wh201906/RFIDetector/README.md

# RFIDetector
An opensource hardware project for detecting reader field type(HF/LF)

## Copyright and License
Copyright (c) 2024 wh201906  

All hardware projects in this repository are licensed under [CERN-OHL-S v2](LICENSE.CERN-OHL-S) or any later version.
