wh201906/RFIDetector/simulation/125k.asc

C1: cap; 47µ; V=6.3 Irms=10.8 Rser=0.00432531 Lser=0 mfg="KEMET" pn="C0603C106K9PAC" type="X5R"
C2: cap; 47µ; V=6.3 Irms=10.8 Rser=0.00432531 Lser=0 mfg="KEMET" pn="C0603C106K9PAC" type="X5R"
C3: cap; 47µ; V=6.3 Irms=10.8 Rser=0.00432531 Lser=0 mfg="KEMET" pn="C0603C106K9PAC" type="X5R"
C4: cap; 47µ; V=6.3 Irms=10.8 Rser=0.00432531 Lser=0 mfg="KEMET" pn="C0603C106K9PAC" type="X5R"
C5: cap; 47µ; V=6.3 Irms=10.8 Rser=0.00432531 Lser=0 mfg="KEMET" pn="C0603C106K9PAC" type="X5R"
C6: cap; 47µ; V=6.3 Irms=10.8 Rser=0.00432531 Lser=0
C7: cap; 47µ; V=6.3 Irms=10.8 Rser=0.00432531 Lser=0 mfg="KEMET" pn="C0603C106K9PAC" type="X5R"
C8: cap; 47µ; V=6.3 Irms=10.8 Rser=0.00432531 Lser=0 mfg="KEMET" pn="C0603C106K9PAC" type="X5R"
C9: cap; 47µ; V=6.3 Irms=10.8 Rser=0.00432531 Lser=0 mfg="KEMET" pn="C0603C106K9PAC" type="X5R"
C10: cap; 10µ; V=6.3 Irms=10.8 Rser=0.00432531 Lser=0 mfg="KEMET" pn="C0603C106K9PAC" type="X5R"
C11: cap; 10µ; V=6.3 Irms=10.8 Rser=0.00432531 Lser=0 mfg="KEMET" pn="C0603C106K9PAC" type="X5R"
C12: cap; 100µ; V=6.3 Irms=10.8 Rser=0.00432531 Lser=0
C13: cap; 100µ; V=6.3 Irms=10.8 Rser=0.00432531 Lser=0 mfg="KEMET" pn="C0603C106K9PAC" type="X5R"
C14: cap; 100µ; V=6.3 Irms=10.8 Rser=0.00432531 Lser=0 mfg="KEMET" pn="C0603C106K9PAC" type="X5R"
C15: cap; 100µ; V=6.3 Irms=10.8 Rser=0.00432531 Lser=0 mfg="KEMET" pn="C0603C106K9PAC" type="X5R"
C16: cap; 100µ; V=6.3 Irms=10.8 Rser=0.00432531 Lser=0
C17: cap; 100µ; V=6.3 Irms=10.8 Rser=0.00432531 Lser=0 mfg="KEMET" pn="C0603C106K9PAC" type="X5R"
C18: cap; 100µ; V=6.3 Irms=10.8 Rser=0.00432531 Lser=0 mfg="KEMET" pn="C0603C106K9PAC" type="X5R"
C19: cap; 100µ; V=6.3 Irms=10.8 Rser=0.00432531 Lser=0 mfg="KEMET" pn="C0603C106K9PAC" type="X5R"
D1: schottky; 1N5819
D2: schottky; 1N5819
D3: LED; L128-RED1003500000
D4: schottky; 1N5819
D5: schottky; 1N5819
D6: schottky; 1N5819
D7: LED; L128-RED1003500000
D8: schottky; 1N5819
D9: schottky; 1N5819
D10: schottky; 1N5819
D11: schottky; 1N5819
D12: LED; L128-RED1003500000
D13: schottky; 1N5819
D14: schottky; 1N5819
D15: LED; L128-RED1003500000
D16: schottky; 1N5819
D17: schottky; 1N5819
D18: schottky; 1N5819
D19: schottky; 1N5819
D20: LED; L128-RED1003500000
D22: schottky; BAS40HY
D23: schottky; BAS40HY
D24: schottky; BAS40HY
D25: schottky; BAS40HY
D26: LED; L128-RED1003500000
V1: voltage; SINE(0 3 125k)
V2: voltage; SINE(0 3 125k)
V3: voltage; SINE(0 3 125k)
V4: voltage; SINE(0 3 125k)
V5: voltage; SINE(0 3 125k)
V6: voltage; SINE(0 3 125k)
Named nets: 0, Vdd-3x-half, Vdd-2x-half, Vdd-4x-half, Vdd-2x-half-2, Vdd-4x-half-2, Vdd-4x-half-3
.tran 2ms
https://zhuanlan.zhihu.com/p/585551041
