wh201906/RFIDetector/simulation/13.56M.asc

C1: cap; 47µ; V=6.3 Irms=10.8 Rser=0.00432531 Lser=0
C2: cap; 47µ; V=6.3 Irms=10.8 Rser=0.00432531 Lser=0 mfg="KEMET" pn="C0603C106K9PAC" type="X5R"
C3: cap; 47µ; V=6.3 Irms=10.8 Rser=0.00432531 Lser=0 mfg="KEMET" pn="C0603C106K9PAC" type="X5R"
C4: cap; 47µ; V=6.3 Irms=10.8 Rser=0.00432531 Lser=0 mfg="KEMET" pn="C0603C106K9PAC" type="X5R"
C5: cap; 47µ; V=6.3 Irms=10.8 Rser=0.00432531 Lser=0
C6: cap; 47µ; V=6.3 Irms=10.8 Rser=0.00432531 Lser=0 mfg="KEMET" pn="C0603C106K9PAC" type="X5R"
C7: cap; 47µ; V=6.3 Irms=10.8 Rser=0.00432531 Lser=0 mfg="KEMET" pn="C0603C106K9PAC" type="X5R"
C8: cap; 47µ; V=6.3 Irms=10.8 Rser=0.00432531 Lser=0 mfg="KEMET" pn="C0603C106K9PAC" type="X5R"
C9: cap; 10µ; V=6.3 Irms=10.8 Rser=0.00432531 Lser=0
C10: cap; 10µ; V=6.3 Irms=10.8 Rser=0.00432531 Lser=0 mfg="KEMET" pn="C0603C106K9PAC" type="X5R"
C11: cap; 10µ; V=6.3 Irms=10.8 Rser=0.00432531 Lser=0 mfg="KEMET" pn="C0603C106K9PAC" type="X5R"
C12: cap; 100µ; V=6.3 Irms=10.8 Rser=0.00432531 Lser=0
C13: cap; 100µ; V=6.3 Irms=10.8 Rser=0.00432531 Lser=0 mfg="KEMET" pn="C0603C106K9PAC" type="X5R"
C14: cap; 100µ; V=6.3 Irms=10.8 Rser=0.00432531 Lser=0 mfg="KEMET" pn="C0603C106K9PAC" type="X5R"
C15: cap; 100µ; V=6.3 Irms=10.8 Rser=0.00432531 Lser=0 mfg="KEMET" pn="C0603C106K9PAC" type="X5R"
C16: cap; 10µ; V=6.3 Irms=10.8 Rser=0.00432531 Lser=0 mfg="KEMET" pn="C0603C106K9PAC" type="X5R"
C20: cap; 100µ; V=6.3 Irms=10.8 Rser=0.00432531 Lser=0
C21: cap; 100µ; V=6.3 Irms=10.8 Rser=0.00432531 Lser=0 mfg="KEMET" pn="C0603C106K9PAC" type="X5R"
C22: cap; 100µ; V=6.3 Irms=10.8 Rser=0.00432531 Lser=0 mfg="KEMET" pn="C0603C106K9PAC" type="X5R"
C23: cap; 100µ; V=6.3 Irms=10.8 Rser=0.00432531 Lser=0 mfg="KEMET" pn="C0603C106K9PAC" type="X5R"
D1: schottky; 1N5819
D2: schottky; 1N5819
D3: schottky; 1N5819
D4: schottky; 1N5819
D5: LED; L128-RED1003500000
D6: schottky; 1N5819
D7: schottky; 1N5819
D8: schottky; 1N5819
D9: schottky; 1N5819
D10: LED; L128-RED1003500000
D11: schottky; 1N5819
D12: schottky; 1N5819
D13: schottky; 1N5819
D14: schottky; 1N5819
D15: LED; L128-RED1003500000
D16: schottky; 1N5819
D17: schottky; 1N5819
D18: schottky; 1N5819
D19: schottky; 1N5819
D20: LED; L128-RED1003500000
D21: schottky; 1N5819
D27: schottky; 1N5819
D28: schottky; 1N5819
D29: schottky; 1N5819
D30: LED; L128-RED1003500000
V1: voltage; SINE(0 3 125k)
V2: voltage; SINE(0 3 13560k)
V3: voltage; SINE(0 3 13560k)
V5: voltage; SINE(0 3 125k)
V7: voltage; SINE(0 3 13560k)
Named nets: 0, Vdd-4x-half-125k, Vdd-4x-half-13M, Vdd-4x-half-125k-2, Vdd-4x-half-13M-2, Vdd-4x-half-13M-3
.tran 800us
https://zhuanlan.zhihu.com/p/585551041
