wh201906/RFIDetector/hardware/rev0.12/RFIDetector.kicad_pcb

## KiCad design hardware/rev0.12/RFIDetector.kicad_pcb (2024-03-22, an earlier design)

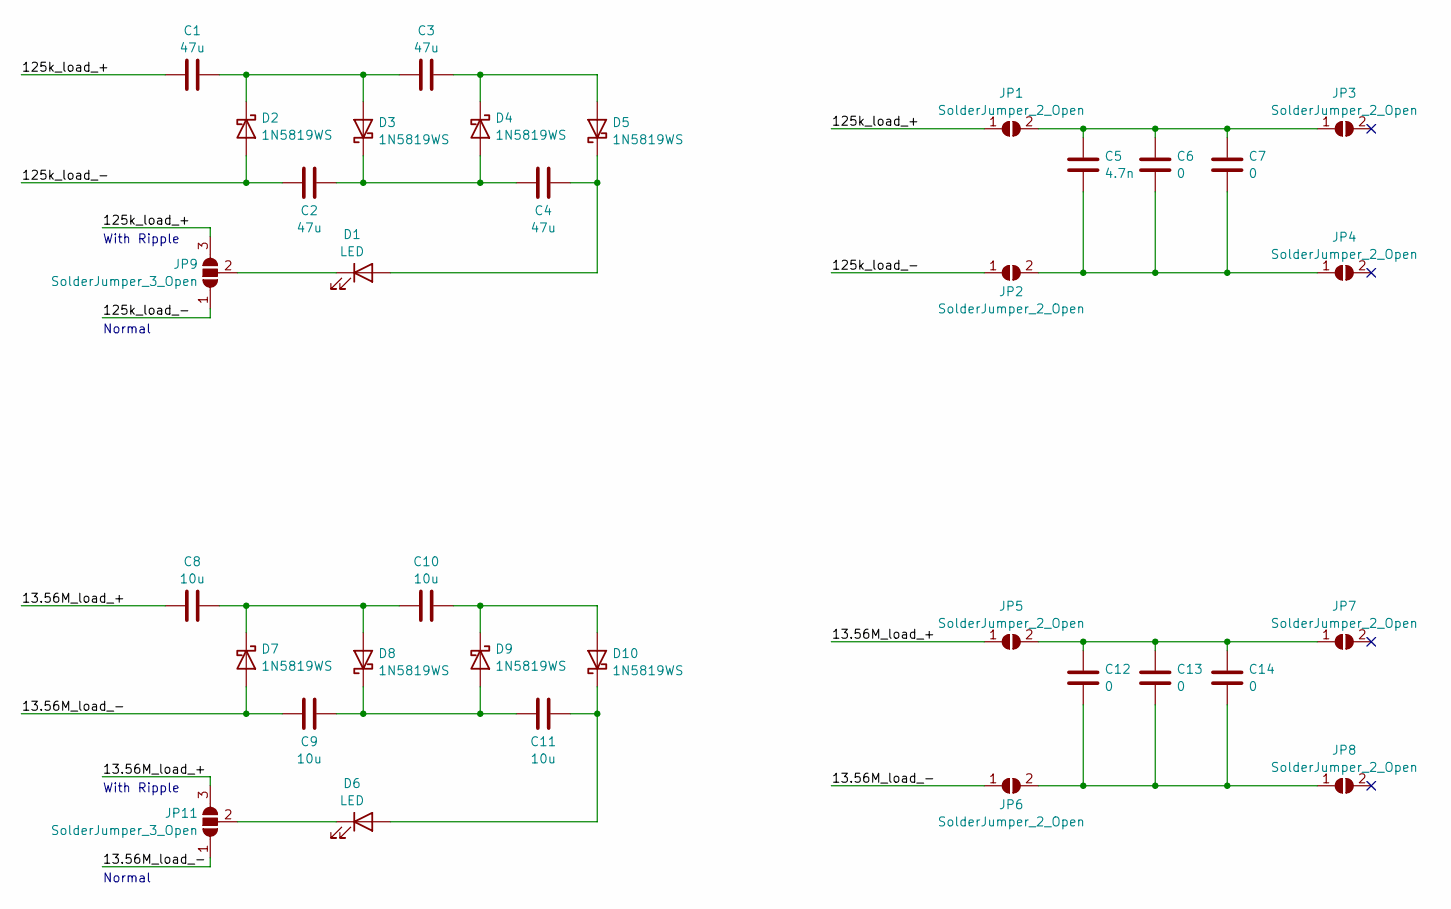
[picture p1: schematic RFIDetector.kicad_sch]

Parts:
C1, C2, C3, C4: 47u; C_0603_1608Metric_Pad1.08x0.95mm_HandSolder
C5: 4.7n; C_0603_1608Metric_Pad1.08x0.95mm_HandSolder
C6, C7, C12, C13, C14: 0; C_0603_1608Metric_Pad1.08x0.95mm_HandSolder
C8, C9, C10, C11: 10u; C_0603_1608Metric_Pad1.08x0.95mm_HandSolder
D1, D6: LED; LED_0603_1608Metric_Pad1.05x0.95mm_HandSolder
D2, D3, D4, D5, D7, D8, D9, D10: 1N5819WS; D_SOD-323_HandSoldering
JP1, JP2, JP3, JP4, JP5, JP6, JP7, JP8: SolderJumper_2_Open; SolderJumper-2_P1.3mm_Open_RoundedPad1.0x1.5mm
JP9, JP11: SolderJumper_3_Open; SolderJumper-3_P1.3mm_Open_RoundedPad1.0x1.5mm

Connections:
/13.56M_load_+: C8.1, JP5.1 (A), JP11.3 (B)
/13.56M_load_-: C9.1, D7.2 (A), JP6.1 (A), JP11.1 (A)
/125k_load_+: C1.1, JP1.1 (A), JP9.3 (B)
/125k_load_-: C2.1, D2.2 (A), JP2.1 (A), JP9.1 (A)
unnamed: C4.2, D1.2 (A), D5.1 (K)
unnamed: D1.1 (K), JP9.2 (C)
unnamed: C1.2, C3.1, D2.1 (K), D3.2 (A)
unnamed: C2.2, C4.1, D3.1 (K), D4.2 (A)
unnamed: C3.2, D4.1 (K), D5.2 (A)
unnamed: D6.1 (K), JP11.2 (C)
unnamed: C8.2, C10.1, D7.1 (K), D8.2 (A)
unnamed: C9.2, C11.1, D8.1 (K), D9.2 (A)
unnamed: C10.2, D9.1 (K), D10.2 (A)
unnamed: C11.2, D6.2 (A), D10.1 (K)
unnamed: C5.2, C6.2, C7.2, JP1.2 (B), JP3.1 (A)
unnamed: C5.1, C6.1, C7.1, JP2.2 (B), JP4.1 (A)
unnamed: C12.1, C13.1, C14.1, JP5.2 (B), JP7.1 (A)
unnamed: C12.2, C13.2, C14.2, JP6.2 (B), JP8.1 (A)

Notes on the sheet:
Normal
With Ripple

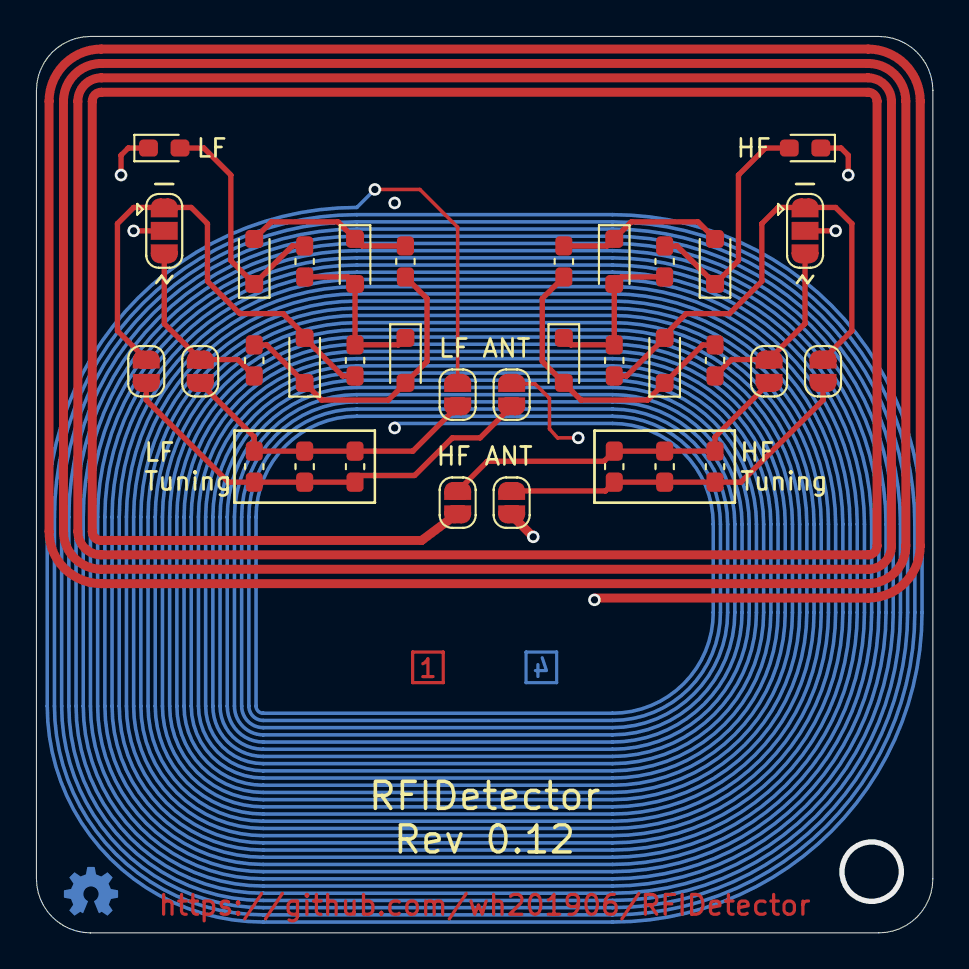
[picture p2: board hardware/rev0.12/RFIDetector.kicad_pcb from above]

Board: 4 copper layers, 49.8 x 49.8 mm, 34 parts (0 on the bottom side), 18 nets.
