wh201906/RFIDetector/tuner/tuner_adapter/tuner_adapter.kicad_pcb

## KiCad design tuner/tuner_adapter/tuner_adapter.kicad_pcb (2024-02-29)

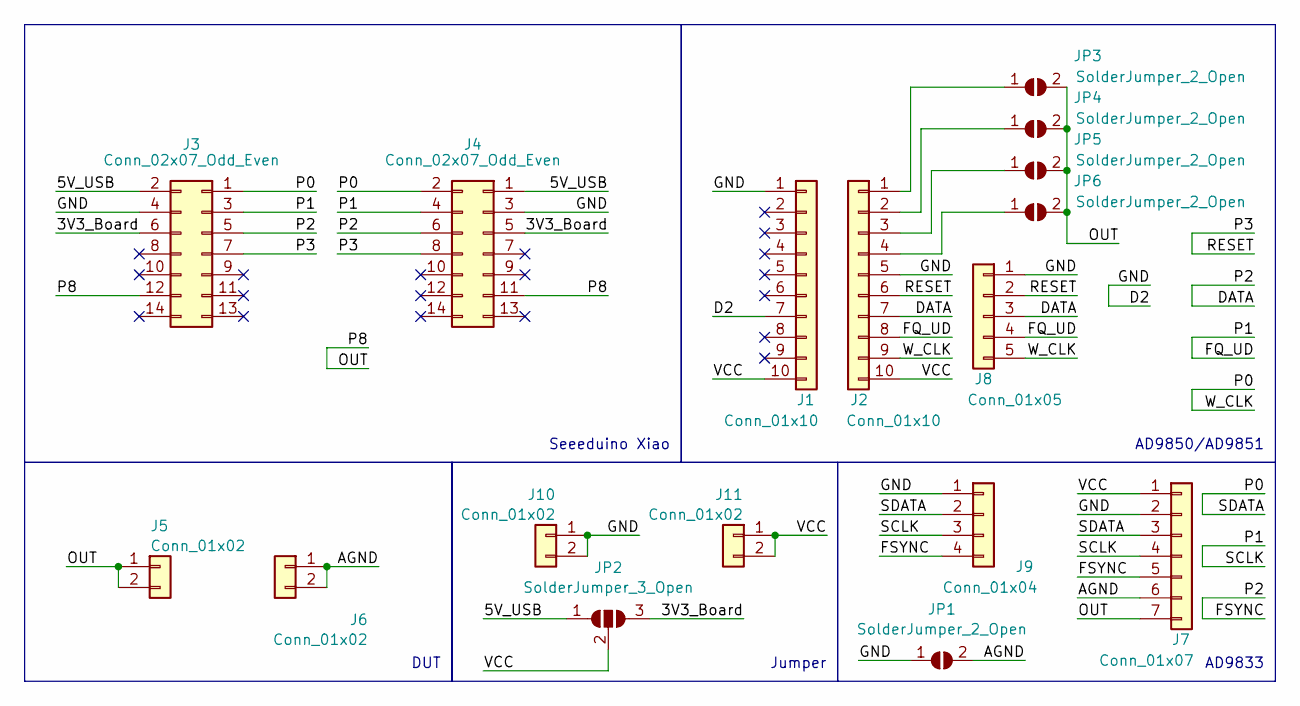
[picture p3: schematic tuner_adapter.kicad_sch]

Parts:
J1, J2: Conn_01x10; PinSocket_1x10_P2.54mm_Vertical
J3, J4: Conn_02x07_Odd_Even; PinSocket_2x07_P2.54mm_Vertical
J5, J6: Conn_01x02; PinSocket_1x02_P2.54mm_Vertical
J7: Conn_01x07; PinSocket_1x07_P2.54mm_Vertical
J8: Conn_01x05; PinHeader_1x05_P2.54mm_Vertical
J9: Conn_01x04; PinHeader_1x04_P2.54mm_Vertical
J10, J11: Conn_01x02; PinHeader_1x02_P2.54mm_Vertical
JP1, JP3, JP4, JP5, JP6: SolderJumper_2_Open; SolderJumper-2_P1.3mm_Open_RoundedPad1.0x1.5mm
JP2: SolderJumper_3_Open; SolderJumper-3_P1.3mm_Open_RoundedPad1.0x1.5mm

Connections:
/3V3_Board: J3.6, J4.5, JP2.3 (B)
/5V_USB: J3.2, J4.1, JP2.1 (A)
/AGND: J6.1, J6.2, J7.6, JP1.2 (B)
/D2: J1.1, J1.7, J2.5, J3.4, J4.3, J7.2, J8.1, J9.1, J10.1, J10.2, JP1.1 (A)
/DATA: J2.7, J3.5, J4.6, J7.5, J8.3, J9.4
/FQ_UD: J2.8, J3.3, J4.4, J7.4, J8.4, J9.3
/OUT: J3.12, J4.11, J5.1, J5.2, J7.7, JP3.2 (B), JP4.2 (B), JP5.2 (B), JP6.2 (B)
/P0: J2.9, J3.1, J4.2, J7.3, J8.5, J9.2
/P3: J2.6, J3.7, J4.8, J8.2
/VCC: J1.10, J2.10, J7.1, J11.1, J11.2, JP2.2 (C)
unnamed: J2.1, JP3.1 (A)
unnamed: J2.2, JP4.1 (A)
unnamed: J2.3, JP5.1 (A)
unnamed: J2.4, JP6.1 (A)

Notes on the sheet:
Jumper
AD9833
AD9850/AD9851
DUT
Seeeduino Xiao

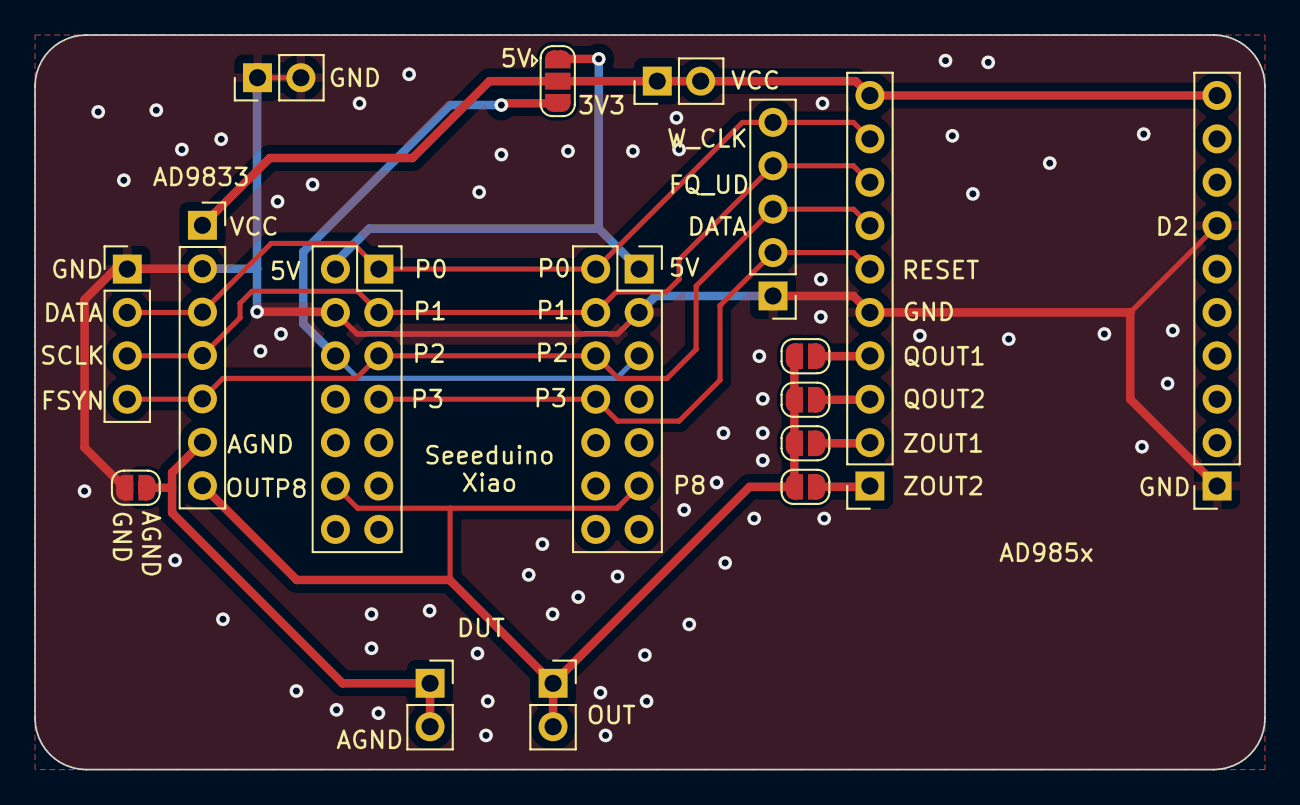
[picture p4: board tuner_adapter.kicad_pcb from above]

Board: 2 copper layers, 72.0 x 43.0 mm, 17 parts (0 on the bottom side), 14 nets.
