wh201906/RFIDetector/hardware/rev0.1/RFIDetector.kicad_pcb

## KiCad design hardware/rev0.1/RFIDetector.kicad_pcb (2024-01-28, an earlier design)

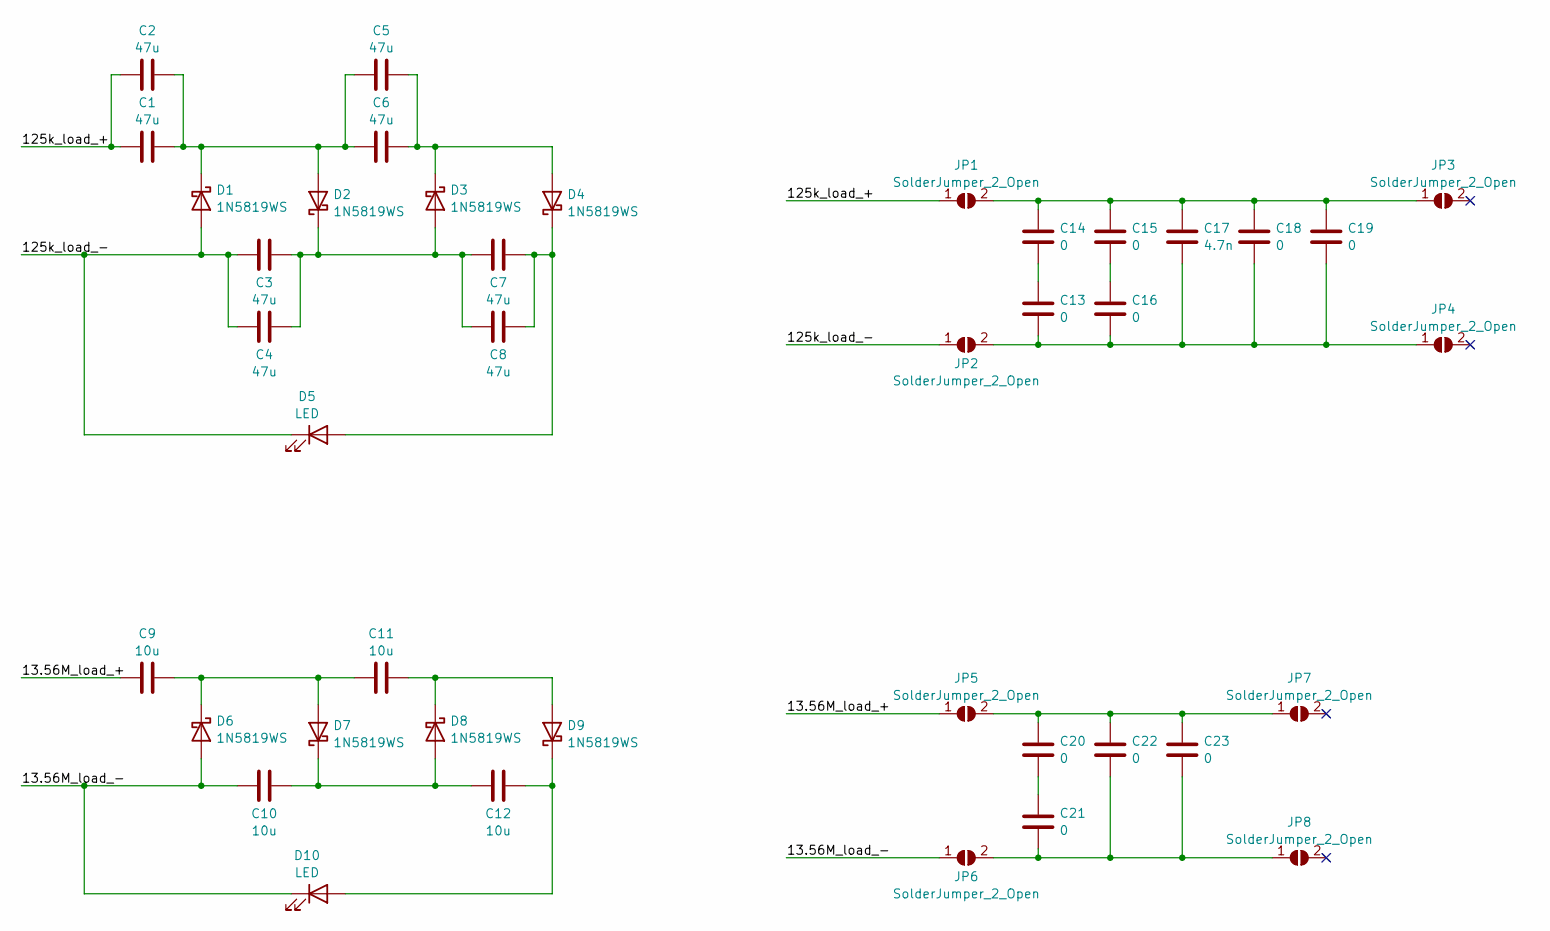
[picture p7: schematic RFIDetector.kicad_sch]

Parts:
C1, C2, C3, C4, C5, C6, C7, C8: 47u; C_0603_1608Metric_Pad1.08x0.95mm_HandSolder
C9, C10, C11, C12: 10u; C_0603_1608Metric_Pad1.08x0.95mm_HandSolder
C13, C14, C15, C16, C18, C19, C20, C21, C22, C23: 0; C_0603_1608Metric_Pad1.08x0.95mm_HandSolder
C17: 4.7n; C_0603_1608Metric_Pad1.08x0.95mm_HandSolder
D1, D2, D3, D4, D6, D7, D8, D9: 1N5819WS; D_SOD-323_HandSoldering
D5, D10: LED; LED_0603_1608Metric_Pad1.05x0.95mm_HandSolder
JP1, JP2, JP3, JP4, JP5, JP6, JP7, JP8: SolderJumper_2_Open; SolderJumper-2_P1.3mm_Open_RoundedPad1.0x1.5mm

Connections:
/13.56M_load_+: C9.1, JP5.1 (A)
/13.56M_load_-: C10.1, D6.2 (A), D10.1 (K), JP6.1 (A)
/125k_load_+: C1.1, C2.1, JP1.1 (A)
/125k_load_-: C3.1, C4.1, D1.2 (A), D5.1 (K), JP2.1 (A)
unnamed: C13.1, C14.1
unnamed: C15.2, C16.1
unnamed: C20.1, C21.1
unnamed: C1.2, C2.2, C5.1, C6.1, D1.1 (K), D2.2 (A)
unnamed: C3.2, C4.2, C7.1, C8.1, D2.1 (K), D3.2 (A)
unnamed: C5.2, C6.2, D3.1 (K), D4.2 (A)
unnamed: C7.2, C8.2, D4.1 (K), D5.2 (A)
unnamed: C9.2, C11.1, D6.1 (K), D7.2 (A)
unnamed: C10.2, C12.1, D7.1 (K), D8.2 (A)
unnamed: C11.2, D8.1 (K), D9.2 (A)
unnamed: C12.2, D9.1 (K), D10.2 (A)
unnamed: C14.2, C15.1, C17.2, C18.2, C19.2, JP1.2 (B), JP3.1 (A)
unnamed: C13.2, C16.2, C17.1, C18.1, C19.1, JP2.2 (B), JP4.1 (A)
unnamed: C20.2, C22.1, C23.1, JP5.2 (B), JP7.1 (A)
unnamed: C21.2, C22.2, C23.2, JP6.2 (B), JP8.1 (A)

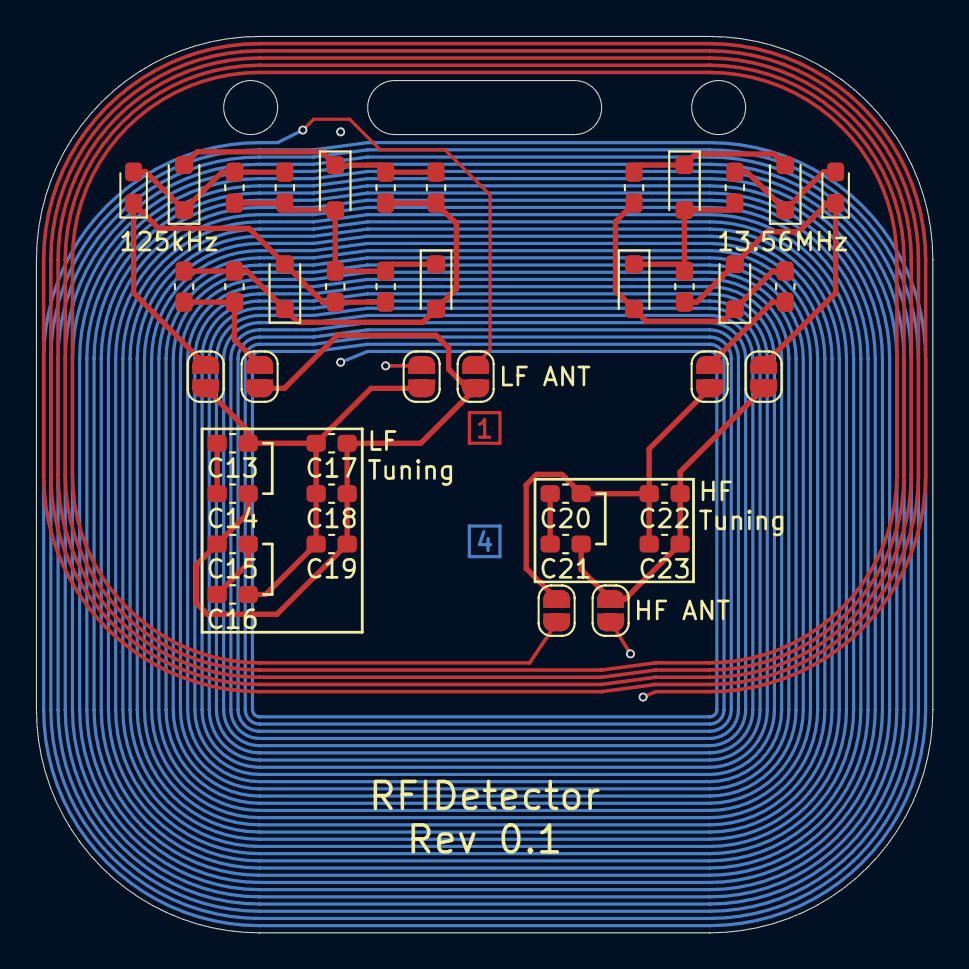
[picture p8: board hardware/rev0.1/RFIDetector.kicad_pcb from above]

Board: 4 copper layers, 49.8 x 49.8 mm, 41 parts (0 on the bottom side), 19 nets.
