wh201906/RFIDetector/hardware/rev0.1/test_results/0.1_1mm_HF_LF4.7nF-HF0_10k-20M_10k.csv

freq | val
10000 | 72
20000 | 74
30000 | 74
40000 | 74
50000 | 74
60000 | 73
70000 | 77
80000 | 77
90000 | 78
100000 | 80
110000 | 84
120000 | 85
130000 | 82
140000 | 81
150000 | 80
160000 | 81
170000 | 81
180000 | 85
190000 | 85
200000 | 84
210000 | 87
220000 | 86
230000 | 85
240000 | 88
250000 | 88
260000 | 88
270000 | 94
280000 | 91
290000 | 92
300000 | 91
310000 | 94
320000 | 96
330000 | 95
340000 | 96
350000 | 97
360000 | 100
370000 | 99
380000 | 102
390000 | 102
400000 | 103
410000 | 107
420000 | 104
430000 | 105
440000 | 107
450000 | 105
460000 | 109
470000 | 108
480000 | 108
490000 | 110
500000 | 114
510000 | 112
520000 | 115
530000 | 113
540000 | 115
550000 | 116
560000 | 121
570000 | 118
580000 | 120
590000 | 120
600000 | 121
610000 | 122
620000 | 123
630000 | 124
640000 | 124
650000 | 126
660000 | 126
670000 | 130
680000 | 129
690000 | 128
700000 | 129
710000 | 131
720000 | 132
730000 | 133
740000 | 135
750000 | 136
760000 | 136
770000 | 139
780000 | 139
790000 | 140
800000 | 141
810000 | 140
820000 | 140
830000 | 146
840000 | 144
850000 | 144
860000 | 147
870000 | 147
880000 | 148
890000 | 149
900000 | 149
910000 | 150
920000 | 151
930000 | 152
940000 | 153
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
