wh201906/RFIDetector/hardware/rev0.1/test_results/0.1_1mm_HF_LF4.7nF-HF100pF_10k-20M_10k.csv

freq | val
10000 | 58
20000 | 56
30000 | 57
40000 | 55
50000 | 58
60000 | 57
70000 | 61
80000 | 62
90000 | 62
100000 | 64
110000 | 69
120000 | 71
130000 | 65
140000 | 66
150000 | 65
160000 | 67
170000 | 64
180000 | 67
190000 | 68
200000 | 69
210000 | 68
220000 | 70
230000 | 73
240000 | 71
250000 | 73
260000 | 73
270000 | 75
280000 | 75
290000 | 79
300000 | 78
310000 | 79
320000 | 84
330000 | 80
340000 | 82
350000 | 82
360000 | 85
370000 | 85
380000 | 86
390000 | 89
400000 | 88
410000 | 89
420000 | 91
430000 | 93
440000 | 92
450000 | 93
460000 | 95
470000 | 98
480000 | 97
490000 | 98
500000 | 100
510000 | 100
520000 | 101
530000 | 102
540000 | 103
550000 | 105
560000 | 104
570000 | 108
580000 | 107
590000 | 108
600000 | 108
610000 | 114
620000 | 110
630000 | 114
640000 | 113
650000 | 115
660000 | 116
670000 | 117
680000 | 117
690000 | 118
700000 | 118
710000 | 122
720000 | 122
730000 | 122
740000 | 123
750000 | 123
760000 | 123
770000 | 125
780000 | 128
790000 | 133
800000 | 130
810000 | 129
820000 | 131
830000 | 133
840000 | 136
850000 | 136
860000 | 136
870000 | 136
880000 | 139
890000 | 138
900000 | 140
910000 | 141
920000 | 142
930000 | 142
940000 | 145
950000 | 144
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
