wh201906/RFIDetector/hardware/rev0.1/test_results/0.1_1mm_HF_LF4.7nF-HF10pF_10k-20M_10k.csv

freq | val
10000 | 66
20000 | 61
30000 | 61
40000 | 61
50000 | 61
60000 | 62
70000 | 65
80000 | 64
90000 | 68
100000 | 68
110000 | 73
120000 | 74
130000 | 71
140000 | 69
150000 | 67
160000 | 70
170000 | 67
180000 | 71
190000 | 70
200000 | 73
210000 | 74
220000 | 75
230000 | 75
240000 | 75
250000 | 77
260000 | 76
270000 | 77
280000 | 81
290000 | 79
300000 | 80
310000 | 83
320000 | 82
330000 | 84
340000 | 85
350000 | 85
360000 | 88
370000 | 89
380000 | 91
390000 | 95
400000 | 91
410000 | 92
420000 | 94
430000 | 98
440000 | 94
450000 | 97
460000 | 97
470000 | 98
480000 | 99
490000 | 100
500000 | 102
510000 | 104
520000 | 103
530000 | 105
540000 | 107
550000 | 107
560000 | 109
570000 | 108
580000 | 110
590000 | 109
600000 | 110
610000 | 112
620000 | 112
630000 | 114
640000 | 116
650000 | 115
660000 | 117
670000 | 118
680000 | 118
690000 | 119
700000 | 119
710000 | 123
720000 | 125
730000 | 123
740000 | 126
750000 | 125
760000 | 127
770000 | 129
780000 | 131
790000 | 129
800000 | 133
810000 | 132
820000 | 132
830000 | 134
840000 | 134
850000 | 136
860000 | 136
870000 | 139
880000 | 138
890000 | 141
900000 | 142
910000 | 140
920000 | 141
930000 | 143
940000 | 145
950000 | 146
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
