wh201906/RFIDetector/hardware/rev0.1/test_results/0.1_1mm_HF_LF4.7nF-HF1pF_10k-20M_10k.csv

freq | val
10000 | 62
20000 | 66
30000 | 60
40000 | 58
50000 | 59
60000 | 61
70000 | 62
80000 | 64
90000 | 66
100000 | 66
110000 | 72
120000 | 72
130000 | 69
140000 | 67
150000 | 66
160000 | 66
170000 | 67
180000 | 68
190000 | 69
200000 | 71
210000 | 70
220000 | 73
230000 | 73
240000 | 74
250000 | 74
260000 | 76
270000 | 76
280000 | 79
290000 | 83
300000 | 81
310000 | 81
320000 | 82
330000 | 83
340000 | 85
350000 | 84
360000 | 85
370000 | 87
380000 | 90
390000 | 89
400000 | 90
410000 | 91
420000 | 92
430000 | 92
440000 | 93
450000 | 95
460000 | 96
470000 | 97
480000 | 100
490000 | 100
500000 | 101
510000 | 101
520000 | 101
530000 | 103
540000 | 103
550000 | 104
560000 | 108
570000 | 107
580000 | 108
590000 | 109
600000 | 110
610000 | 110
620000 | 111
630000 | 114
640000 | 113
650000 | 113
660000 | 117
670000 | 117
680000 | 118
690000 | 120
700000 | 121
710000 | 121
720000 | 121
730000 | 123
740000 | 124
750000 | 124
760000 | 126
770000 | 128
780000 | 126
790000 | 130
800000 | 131
810000 | 132
820000 | 133
830000 | 132
840000 | 133
850000 | 136
860000 | 137
870000 | 137
880000 | 138
890000 | 138
900000 | 141
910000 | 142
920000 | 141
930000 | 140
940000 | 144
950000 | 146
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
