wh201906/RFIDetector/hardware/rev0.1/test_results/0.1_1mm_HF_LF4.7nF-HF220pF_10k-20M_10k.csv

freq | val
10000 | 63
20000 | 56
30000 | 55
40000 | 56
50000 | 58
60000 | 60
70000 | 61
80000 | 61
90000 | 63
100000 | 65
110000 | 67
120000 | 70
130000 | 66
140000 | 63
150000 | 65
160000 | 65
170000 | 65
180000 | 65
190000 | 67
200000 | 66
210000 | 70
220000 | 70
230000 | 67
240000 | 71
250000 | 73
260000 | 74
270000 | 76
280000 | 77
290000 | 77
300000 | 79
310000 | 80
320000 | 82
330000 | 84
340000 | 82
350000 | 83
360000 | 86
370000 | 85
380000 | 86
390000 | 90
400000 | 89
410000 | 89
420000 | 90
430000 | 93
440000 | 95
450000 | 94
460000 | 93
470000 | 98
480000 | 95
490000 | 98
500000 | 99
510000 | 100
520000 | 101
530000 | 102
540000 | 105
550000 | 106
560000 | 107
570000 | 105
580000 | 105
590000 | 106
600000 | 108
610000 | 112
620000 | 115
630000 | 113
640000 | 117
650000 | 115
660000 | 114
670000 | 116
680000 | 117
690000 | 118
700000 | 117
710000 | 119
720000 | 124
730000 | 124
740000 | 126
750000 | 125
760000 | 127
770000 | 126
780000 | 130
790000 | 129
800000 | 129
810000 | 131
820000 | 134
830000 | 134
840000 | 134
850000 | 133
860000 | 134
870000 | 136
880000 | 138
890000 | 138
900000 | 140
910000 | 140
920000 | 140
930000 | 143
940000 | 145
950000 | 146
960000 | 146
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
