wh201906/RFIDetector/hardware/rev0.1/test_results/0.1_1mm_HF_LF4.7nF-HF22pF_10k-20M_10k.csv

freq | val
10000 | 55
20000 | 57
30000 | 57
40000 | 57
50000 | 58
60000 | 59
70000 | 60
80000 | 60
90000 | 63
100000 | 66
110000 | 68
120000 | 71
130000 | 67
140000 | 63
150000 | 63
160000 | 66
170000 | 65
180000 | 69
190000 | 65
200000 | 69
210000 | 68
220000 | 70
230000 | 74
240000 | 70
250000 | 77
260000 | 76
270000 | 77
280000 | 79
290000 | 78
300000 | 78
310000 | 80
320000 | 79
330000 | 82
340000 | 82
350000 | 85
360000 | 85
370000 | 86
380000 | 87
390000 | 90
400000 | 88
410000 | 89
420000 | 89
430000 | 94
440000 | 96
450000 | 94
460000 | 95
470000 | 94
480000 | 98
490000 | 98
500000 | 97
510000 | 99
520000 | 100
530000 | 104
540000 | 102
550000 | 103
560000 | 103
570000 | 106
580000 | 105
590000 | 107
600000 | 106
610000 | 109
620000 | 110
630000 | 112
640000 | 111
650000 | 115
660000 | 114
670000 | 117
680000 | 115
690000 | 118
700000 | 119
710000 | 118
720000 | 120
730000 | 123
740000 | 123
750000 | 123
760000 | 125
770000 | 127
780000 | 128
790000 | 129
800000 | 132
810000 | 130
820000 | 130
830000 | 131
840000 | 134
850000 | 135
860000 | 135
870000 | 137
880000 | 136
890000 | 137
900000 | 144
910000 | 138
920000 | 140
930000 | 141
940000 | 143
950000 | 142
960000 | 143
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
