wh201906/RFIDetector/(commit log)

2024-01-12 Rev 0.1, untested, untuned
    [RFIDetector.kicad_pcb, RFIDetector.kicad_sch]
2024-01-28 Rev 0.1
    [RFIDetector.kicad_pcb, RFIDetector.kicad_sch]
2024-01-29 Rev 0.2, untested, untuned
    Set the board size to 49.8mm x 40.0mm
    Set the trace width of LF antenna to 0.2mm
    Set the trace width of HF antenna to 0.5mm
    Set the spacing of HF antenna to 0.3mm
    Set the via size to 0.4mm/0.7mm
    Removed some holes
    Changed the hole type(NPTH->PTH)
    Removed some unnecessary capacitors
    Changed the frequency label(125kHz->LF, 13.56MHz->LF)
    Added extra solder mask openings to show the LED state on the back side
    Changed the spacing between the components
    [RFIDetector.kicad_pcb, RFIDetector.kicad_sch]
2024-01-29 Rev 0.21, untested, untuned
    Reduced the number of turns of HF antenna(5->4) for lower inductance
    Hide the jumper wire of HF antenna into the inner layer
    [RFIDetector_Rev0.21.kicad_pcb]
2024-02-03 Add tuner script and some tuning result of Rev 0.1
    Just a prototype
    [hf_0.csv, hf_1pf.csv, hf_6.8pf.csv, lf_0.csv, lf_4.7nf.csv]
2024-02-20 Rev 0.22, untested, untuned
    Decreased the size of LF antenna to reduce the overlapped part
    Flipped the "3" and "4" mark
    [RFIDetector.kicad_pcb, RFIDetector.kicad_sch]
2024-02-23 Rev 0.11, untested, untuned
    Apply some changes from Rev 0.2x, but keep the size and coil layout
    unchanged
    [RFIDetector.kicad_pcb, RFIDetector.kicad_sch]
2024-02-29 Add tuner adapter project
    Less jump wires and much less noise on ADC
    [tuner_adapter.kicad_pcb, tuner_adapter.kicad_sch]
2024-03-01 Add test results
    The signal is from AD9851
    [0.11_1mm_HF_LF4.7nF-HF0_10k-20M_10k.csv, 0.11_1mm_HF_LF4.7nF-HF100pF_10k-20M_10k.csv, 0.11_1mm_HF_LF4.7nF-HF10pF_10k-20M_10k.csv, 0.11_1mm_HF_LF4.7nF-HF1pF_10k-20M_10k.csv, 0.11_1mm_HF_LF4.7nF-HF220pF_10k-20M_10k.csv, 0.11_1mm_HF_LF4.7nF-HF22pF_10k-20M_10k.csv, 0.11_1mm_LF_LF4.7nF-HF0_10k-1M_1k.csv, 0.11_1mm_LF_LF4.7nF-HF0_10k-20M_10k.csv]
2024-03-07 Add test results
    [0.11_1.6mm_HF_LF4.7nF-HF0_10k-20M_10k.csv, 0.11_1.6mm_HF_LF4.7nF-HF100pF_10k-20M_10k.csv, 0.11_1.6mm_HF_LF4.7nF-HF10pF_10k-20M_10k.csv, 0.11_1.6mm_HF_LF4.7nF-HF1pF_10k-20M_10k.csv, 0.11_1.6mm_HF_LF4.7nF-HF220pF_10k-20M_10k.csv, 0.11_1.6mm_HF_LF4.7nF-HF22pF_10k-20M_10k.csv, 0.11_1.6mm_LF_LF4.7nF-HF0_10k-1M_1k.csv, 0.11_1.6mm_LF_LF4.7nF-HF0_10k-20M_10k.csv]
2024-03-22 Rev 0.12, untested, untuned
    Align some components
    Decrease the size of the coils
    Make more gaps around the coils
    Add silkscreens to indicate normal/jitter mode
    This revision is based on Rev 0.11, but saved as KiCad 8 project.
    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
    [RFIDetector.kicad_pcb, RFIDetector.kicad_sch]
